kalpeshpatil/StellariumLaserPointer/README.md

# Stellarium based automated laser pointer
